Felipe-chr/RoboTZero/Docs/AuralFocus/auralfocus-intro.qmd

# First Technical Analysis and Architecture

This document presents the first technical analysis and proposed architecture for an artificial hearing system with capabilities that approach and in some aspects surpass human audition. The system employs six digital [MEMS](https://grokipedia.com/page/MEMS) microphones organized in two blocks of three elements each, enabling three-dimensional spatial localization of sound sources with extended dynamic range and advanced real-time digital signal processing capabilities.

The central objective is to create a device capable of identifying the origin of sound sources with angular resolution of three to five degrees, recording high-quality audio across the full audible spectrum, and detecting sporadic acoustic events such as explosions and aircraft with sub-20 millisecond latency. The architecture adopts an all-digital approach using I²S/PDM MEMS microphones, which significantly simplifies the analog design while maintaining professional-grade audio quality and reducing bill-of-materials cost to approximately sixty dollars.

## Fundamentals: Comparison Between Auditory Systems

To understand the project requirements and design decisions, we begin by analyzing the differences between human hearing, canine hearing, and the proposed system. This comparative analysis reveals both the biological limitations we seek to overcome and the engineering constraints that define practical boundaries.

### Human Auditory Characteristics

The human auditory system presents well-defined characteristics that have been extensively studied in psychoacoustic research. The audible frequency band extends from $20 \text{Hz}$ to approximately $20  \text{kHz}$ in young adults, though this upper limit degrades with age, typically reaching only $12$ to $15 \text{kHz}$ by age sixty. Maximum sensitivity occurs in the range between $2 \text{kHz}$ and  $4 \text{kHz}$, which corresponds to the fundamental frequencies and first formants of human speech, reflecting evolutionary optimization for verbal communication.

The dynamic range of human hearing, measured as the difference between the threshold of hearing and the threshold of pain, reaches approximately $120 \text{dB}$. This remarkable range allows us to perceive sounds from the faint rustle of leaves at $10 \text{dB}$ **S**ound **P**ressure Sound Pressure Levelevel, Sound Pressure Level to the roar of jet engines at $130 \text{dB}$ SPL. However, this sensitivity comes with vulnerability to acoustic trauma from prolonged exposure to high-intensity sounds above $85 \text{dB}$ **SPL**.

Human spatial localization capability depends fundamentally on two binaural mechanisms that exploit the separation between our ears. The first mechanism is Interaural Time Difference (ITD), which represents the difference in sound arrival time between the two ears. For a sound source positioned laterally, considering the typical interaural separation of approximately 17 centimeters in adult humans, we can calculate the maximum ITD:

$$
\text{ITD}_{\text{max}} = \frac{d}{v_{\text{sound}}} = \frac{0.17 \text{ m}}{343 \text{ m/s}} \approx 495 \text{ μs}
$$

This half-millisecond time difference is remarkably small, yet the human auditory system can detect differences as small as 10 microseconds, corresponding to angular discrimination of approximately one to two degrees in the frontal hemisphere. The sensitivity to **I**nteraural **T**ime **D**ifference, **ITD**, is greatest for frequencies below $1.5\text{kHz}$, where phase information remains unambiguous across the entire audible range.

The second mechanism is **I**nteraural **L**evel **D**ifference, **ILD**, which represents the difference in sound intensity between the ears due to the acoustic shadow cast by the head. This effect becomes significant when the wavelength of sound is smaller than or comparable to head dimensions. For a spherical head of approximately $18 \text{centimeters}$ diameter, this occurs at frequencies above approximately $2 \text{kHz}$:

$$f_{\text{ILD}} = \frac{v_{\text{sound}}}{\pi d_{\text{head}}} = \frac{343 \text{ m/s}}{\pi \times 0.18 \text{ m}} \approx 607 \text{ Hz}$$

Above this frequency, the head increasingly attenuates sound reaching the far ear, creating level differences that can exceed $20\text{dB}$ for pure lateral sources at high frequencies. The brain integrates both **ITD** and **ILD** cues to create a robust spatial representation, with **ITD** dominating at low frequencies and **ILD** at high frequencies.

Human angular resolution varies significantly with direction. In the frontal region, where both ears receive similar stimulation and head movements can disambiguate front-back confusions, we achieve resolution of approximately one degree. This exceptional acuity degrades to approximately $10$ to $15 \test{degrees}$ in lateral and posterior regions, where cone of confusion effects and reduced binaural information limit performance.

**[SVG DIAGRAM 1: Illustration of the human auditory system showing the 17cm interaural separation, with visualization of sound waves arriving from different angles and visual indication of ITD and ILD mechanisms]**

### Canine Auditory Characteristics

Canine hearing presents characteristics that make it superior to human hearing in specific aspects, reflecting evolutionary adaptations to different ecological niches. The frequency band extends from approximately 40 Hz to 60 kHz, with some breeds capable of detecting frequencies approaching 65 kHz. This extended high-frequency response enables dogs to perceive ultrasonic vocalizations from prey animals and potentially detect some electronic devices that emit ultrasonic noise.

Maximum sensitivity occurs between 8 kHz and 16 kHz, approximately one octave above peak human sensitivity. This shift reflects optimization for detecting higher-pitched sounds, including rodent vocalizations and rustling movements in vegetation. The dynamic range is similar to humans at approximately 100 dB, though dogs show greater sensitivity to faint sounds, with hearing thresholds 4 to 6 dB lower than human thresholds across most of the audible spectrum.

The separation between canine ears varies considerably with breed, typically ranging from 5 centimeters in small breeds to 10 centimeters in large breeds. Although smaller than human interaural separation, dogs compensate through independent pinnae mobility. Each external ear can rotate through approximately 180 degrees under precise muscular control, allowing dogs to actively scan the acoustic environment and effectively increase their spatial sampling aperture. This mobility provides dogs with dynamic beamforming capability that humans lack, partially offsetting the geometric disadvantage of smaller baseline.

Canine angular resolution in azimuth is estimated at approximately 5 degrees under optimal conditions, somewhat inferior to frontal human resolution but superior to human performance in lateral directions. The ability to rapidly orient pinnae toward sound sources provides dogs with faster spatial acquisition than humans, who must rely primarily on head movements for spatial disambiguation.

### Proposed System Specifications

The system we are designing seeks to combine the best characteristics of biological auditory systems while adding capabilities enabled by digital signal processing that have no biological analogue. The design philosophy emphasizes practical utility over theoretical perfection, focusing on capabilities that provide clear value for the intended applications of sound source localization, event detection, and high-quality audio recording.

The useful frequency band will extend from 20 Hz to 20 kHz, covering the complete audible range with flat response. While this lacks the ultrasonic extension of canine hearing, it provides complete coverage of acoustically relevant content for our target applications. The vast majority of informative content in explosions, aircraft noise, and speech occurs below 10 kHz, with harmonics extending to 20 kHz. Even for ultrasonic events such as bat echolocation or pneumatic leaks, the presence of harmonics within the audible band often provides sufficient detection capability.

The target dynamic range is 120 dB, matching human capability and allowing capture of sounds from very weak (20 dB SPL, equivalent to a quiet room) to extremely intense (140 dB SPL, near aircraft engines). The frequency response will be optimized to remain flat within ±2 dB from 100 Hz to 16 kHz, degrading gradually to ±3 dB at 20 kHz, providing faithful representation of sound sources without coloration.

The target angular resolution is 3 to 5 degrees in azimuth and 5 to 10 degrees in elevation. Although the system lacks physical mobility like canine pinnae, we compensate through digital beamforming, which allows electronically steering array sensitivity across the entire spatial hemisphere with millisecond update rates. This provides spatial tracking capability that exceeds biological systems for rapidly moving sources.

The system latency target is less than 20 milliseconds from acoustic event to digital output, enabling real-time monitoring and triggering applications. Processing will occur entirely on the embedded microcontroller, eliminating dependence on external computing resources and enabling standalone operation.

**[SVG DIAGRAM 2: Side-by-side comparison of the three auditory systems (human, canine, proposed) showing frequency bands on a logarithmic scale, with emphasis on regions of maximum sensitivity and dynamic range bars]**

## Microphone Array Geometry

The choice of microphone array geometry fundamentally determines the spatial localization capabilities and dictates many subsequent design decisions. The proposed configuration consists of two blocks of three microphones each, arranged vertically and separated horizontally, creating what we term a binaural array architecture.

### Topology and Dimensions

Each vertical block contains three microphones uniformly spaced by 15 millimeters center-to-center, resulting in a total aperture of 30 millimeters per block. The two blocks are separated horizontally by a distance of 100 millimeters, measured between the center microphones of each block. This creates a configuration that replicates the essential geometry of binaural hearing while adding a vertical dimension absent in simple two-microphone systems.

This geometry was selected through iterative analysis of several competing requirements. First, the vertical arrangement of microphones in each block enables beamforming in the elevation plane through delay-and-sum or more sophisticated adaptive techniques. Second, the horizontal separation between blocks provides sufficient baseline for exploiting both ITD and ILD cues to determine azimuth, similar to biological binaural hearing. Third, the compact overall dimensions (100 mm × 30 mm) permit mounting on a single printed circuit board without mechanical complexity.

The choice of 15 millimeter vertical spacing represents a compromise between spatial resolution and aliasing. Tighter spacing would reduce aliasing frequency but decrease angular resolution. Wider spacing would improve resolution but introduce ambiguities at lower frequencies. The selected spacing provides acceptable performance across the frequency range of interest.

The 100 millimeter horizontal separation was chosen to approximate the effective acoustic baseline of small animals while remaining compatible with standard PCB manufacturing. This separation provides ITD values up to approximately 290 microseconds for pure lateral sources, sufficient for unambiguous localization using correlation-based methods across the full audible band.

**[SVG DIAGRAM 3: Front and top view of the array showing the positions of the 6 microphones. Front view shows the two vertical blocks separated by 10cm. Top view shows the 10cm baseline. Include coordinate system with x, y, z axes clearly marked and microphone numbering]**

### Spacing Calculation and Spatial Aliasing

A critical concept in microphone array design is spatial aliasing, directly analogous to temporal aliasing in discrete-time signal processing. When the spacing between array elements exceeds half the wavelength of the incoming sound, ambiguities arise in determining the direction of arrival. Multiple spatial angles can produce identical phase relationships across the array, creating what are termed grating lobes in the array response pattern.

To avoid spatial aliasing, the spacing between adjacent elements must satisfy:

$$
d < \frac{\lambda_{\text{min}}}{2} = \frac{v_{\text{sound}}}{2 f_{\text{max}}}
$$

For our maximum frequency of interest of 20 kHz, this yields:

$$
\lambda_{\text{min}} = \frac{343 \text{ m/s}}{20000 \text{ Hz}} = 17.15 \text{ mm}
$$

Therefore, the maximum spacing to avoid aliasing is:

$$
d_{\text{max}} = \frac{17.15 \text{ mm}}{2} = 8.58 \text{ mm}
$$

Our chosen spacing of 15 millimeters exceeds this limit by a factor of 1.75, which means we will experience spatial aliasing above approximately:

$$
f_{\text{aliasing}} = \frac{v_{\text{sound}}}{2 \times d} = \frac{343 \text{ m/s}}{2 \times 0.015 \text{ m}} \approx 11.4 \text{ kHz}
$$

This represents a conscious design trade-off. Spatial aliasing above 11.4 kHz creates ambiguities in direction of arrival estimation, but several factors mitigate this limitation. First, most acoustic events of interest (speech, explosions, vehicle noise) contain their principal informative content below 10 kHz. Second, even when aliasing occurs, the energy detection and beamforming gain remain valid, only the precise angle-of-arrival becomes ambiguous. Third, the horizontal baseline of 100 millimeters provides an independent measurement at a different spatial frequency that helps resolve some ambiguities.

For applications requiring unambiguous localization across the full 20 kHz band, the vertical spacing would need to be reduced to approximately 8 millimeters. However, this would increase manufacturing difficulty and reduce the total vertical aperture, degrading elevation resolution. The chosen design prioritizes practical manufacturability and optimizes performance in the most critical frequency range.

### Local Beamforming Capabilities

Each vertical block of three microphones forms a uniform linear array (ULA) capable of performing beamforming in the elevation plane. For a ULA with $N$ elements spaced by distance $d$, the far-field array pattern when steering to angle $\theta_0$ from the array normal is given by:

$$
H(\theta, \omega) = \sum_{n=0}^{N-1} w_n e^{j \omega \tau_n}
$$

where $w_n$ are complex weights and $\tau_n = (n d \sin(\theta))/v_{\text{sound}}$ is the acoustic delay to element $n$. For a simple delay-and-sum beamformer with uniform weighting ($w_n = 1/N$), this simplifies to:

$$
H(\theta, \omega) = \frac{1}{N} \frac{\sin(N \omega d \sin(\theta) / (2 v_{\text{sound}}))}{\sin(\omega d \sin(\theta) / (2 v_{\text{sound}}))}
$$

The directivity pattern exhibits a main lobe centered at the steering angle $\theta_0$ and side lobes at angles where the path length differences equal integer multiples of the wavelength. The main lobe width at the -3 dB points is approximated by:

$$
\Delta\theta_{3\text{dB}} \approx \frac{0.886 \lambda}{(N-1)d}
$$

For our vertical array with $N=3$, $d=15$ millimeters, at a frequency of 1 kHz where $\lambda = 343$ millimeters:

$$
\Delta\theta_{3\text{dB}} \approx \frac{0.886 \times 343 \text{ mm}}{2 \times 15 \text{ mm}} \approx 10.1°
$$

This represents the angular resolution in elevation at 1 kHz. The beamwidth narrows at higher frequencies, reaching approximately 2.5 degrees at 4 kHz, our frequency of peak array gain. The directivity gain, which represents the improvement in signal-to-noise ratio achieved by coherent summation, is approximately:

$$
G_{\text{array}} = 10 \log_{10}(N) = 10 \log_{10}(3) \approx 4.8 \text{ dB}
$$

This 4.8 dB gain applies when the desired signal arrives from the steering direction and noise is spatially uncorrelated. In practice, gains of 3 to 4 dB are typical accounting for microphone mismatch and finite coherence of the desired signal.

**[SVG DIAGRAM 4: Polar pattern of vertical beamforming showing the main lobe and side lobes at three frequencies: 500 Hz (wide beam), 2 kHz (medium), and 8 kHz (narrow). Include angular scale in degrees and magnitude scale in dB]**

### Binaural Analysis for Azimuth Determination

The 100 millimeter horizontal separation between left and right blocks enables binaural analysis for azimuth determination. For a sound source at azimuth angle $\phi$ measured from the frontal direction, the maximum interaural time difference for pure lateral incidence ($\phi = 90°$) is:

$$
\text{ITD}_{\text{max}} = \frac{d_{\text{separation}}}{v_{\text{sound}}} = \frac{0.10 \text{ m}}{343 \text{ m/s}} \approx 291 \text{ μs}
$$

For arbitrary azimuth angles, the ITD can be approximated under far-field conditions by:

$$
\text{ITD}(\phi) = \frac{d_{\text{separation}}}{v_{\text{sound}}} \sin(\phi)
$$

This relationship is valid when the source distance greatly exceeds the array dimensions, allowing treatment of the wavefront as planar. For sources within approximately two meters, near-field corrections become necessary to account for wavefront curvature.

The angular resolution achievable through ITD analysis depends on the minimum detectable time difference, which is limited by sampling rate, signal-to-noise ratio, and correlation processing gain. With a sampling rate of 48 kHz providing temporal resolution of approximately 21 microseconds, and assuming signal-to-noise ratio of 20 dB enabling detection of time delays to approximately 10 microseconds through correlation processing, the theoretical angular resolution is:

$$
\Delta\phi_{\text{min}} = \arcsin\left(\frac{v_{\text{sound}} \times \Delta t_{\text{min}}}{d_{\text{separation}}}\right) = \arcsin\left(\frac{343 \text{ m/s} \times 10 \times 10^{-6} \text{ s}}{0.10 \text{ m}}\right) \approx 2.0°
$$

This calculation indicates that our geometry is capable of achieving the target angular resolution of 3 to 5 degrees with margin. In practice, reverberation, competing sources, and finite signal bandwidth will degrade performance from this theoretical limit, but the fundamental geometry provides adequate capability.

The interaural level difference also contributes to azimuth determination, particularly at high frequencies where the wavelength becomes comparable to the array dimensions. For our 100 millimeter separation, ILD becomes significant above approximately:

$$
f_{\text{ILD}} = \frac{v_{\text{sound}}}{\pi d_{\text{separation}}} = \frac{343 \text{ m/s}}{\pi \times 0.10 \text{ m}} \approx 1.1 \text{ kHz}
$$

Above this frequency, each vertical block begins to shadow the other for lateral sources, creating level differences that complement ITD cues. The magnitude of ILD increases with frequency and angle, potentially reaching 10 to 15 dB for high-frequency pure lateral sources.

**[SVG DIAGRAM 5: Top view showing plane waves arriving at different azimuth angles (0°, 30°, 60°, 90°) with visualization of path length differences between left and right blocks. Include time delay annotations and graphical wavefront representations]**
