Felipe-chr/RoboTZero/Docs/AuralFocus/images/STMPowerDistShcdV1.webp

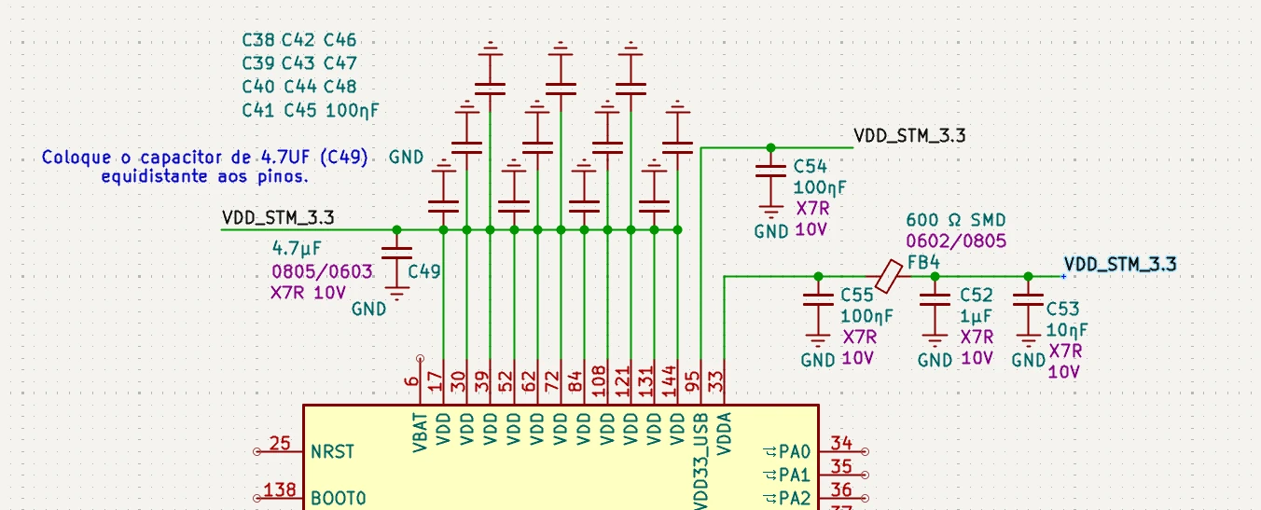
Docs/AuralFocus/images/STMPowerDistShcdV1.webp
