Felipe-chr/RoboTZero/AuralFocus/hardware/aurial1/aurialPiHat/aurialPiHat.kicad_sch

## KiCad design AuralFocus/hardware/aurial1/aurialPiHat/aurialPiHat.kicad_sch (2026-01-05)

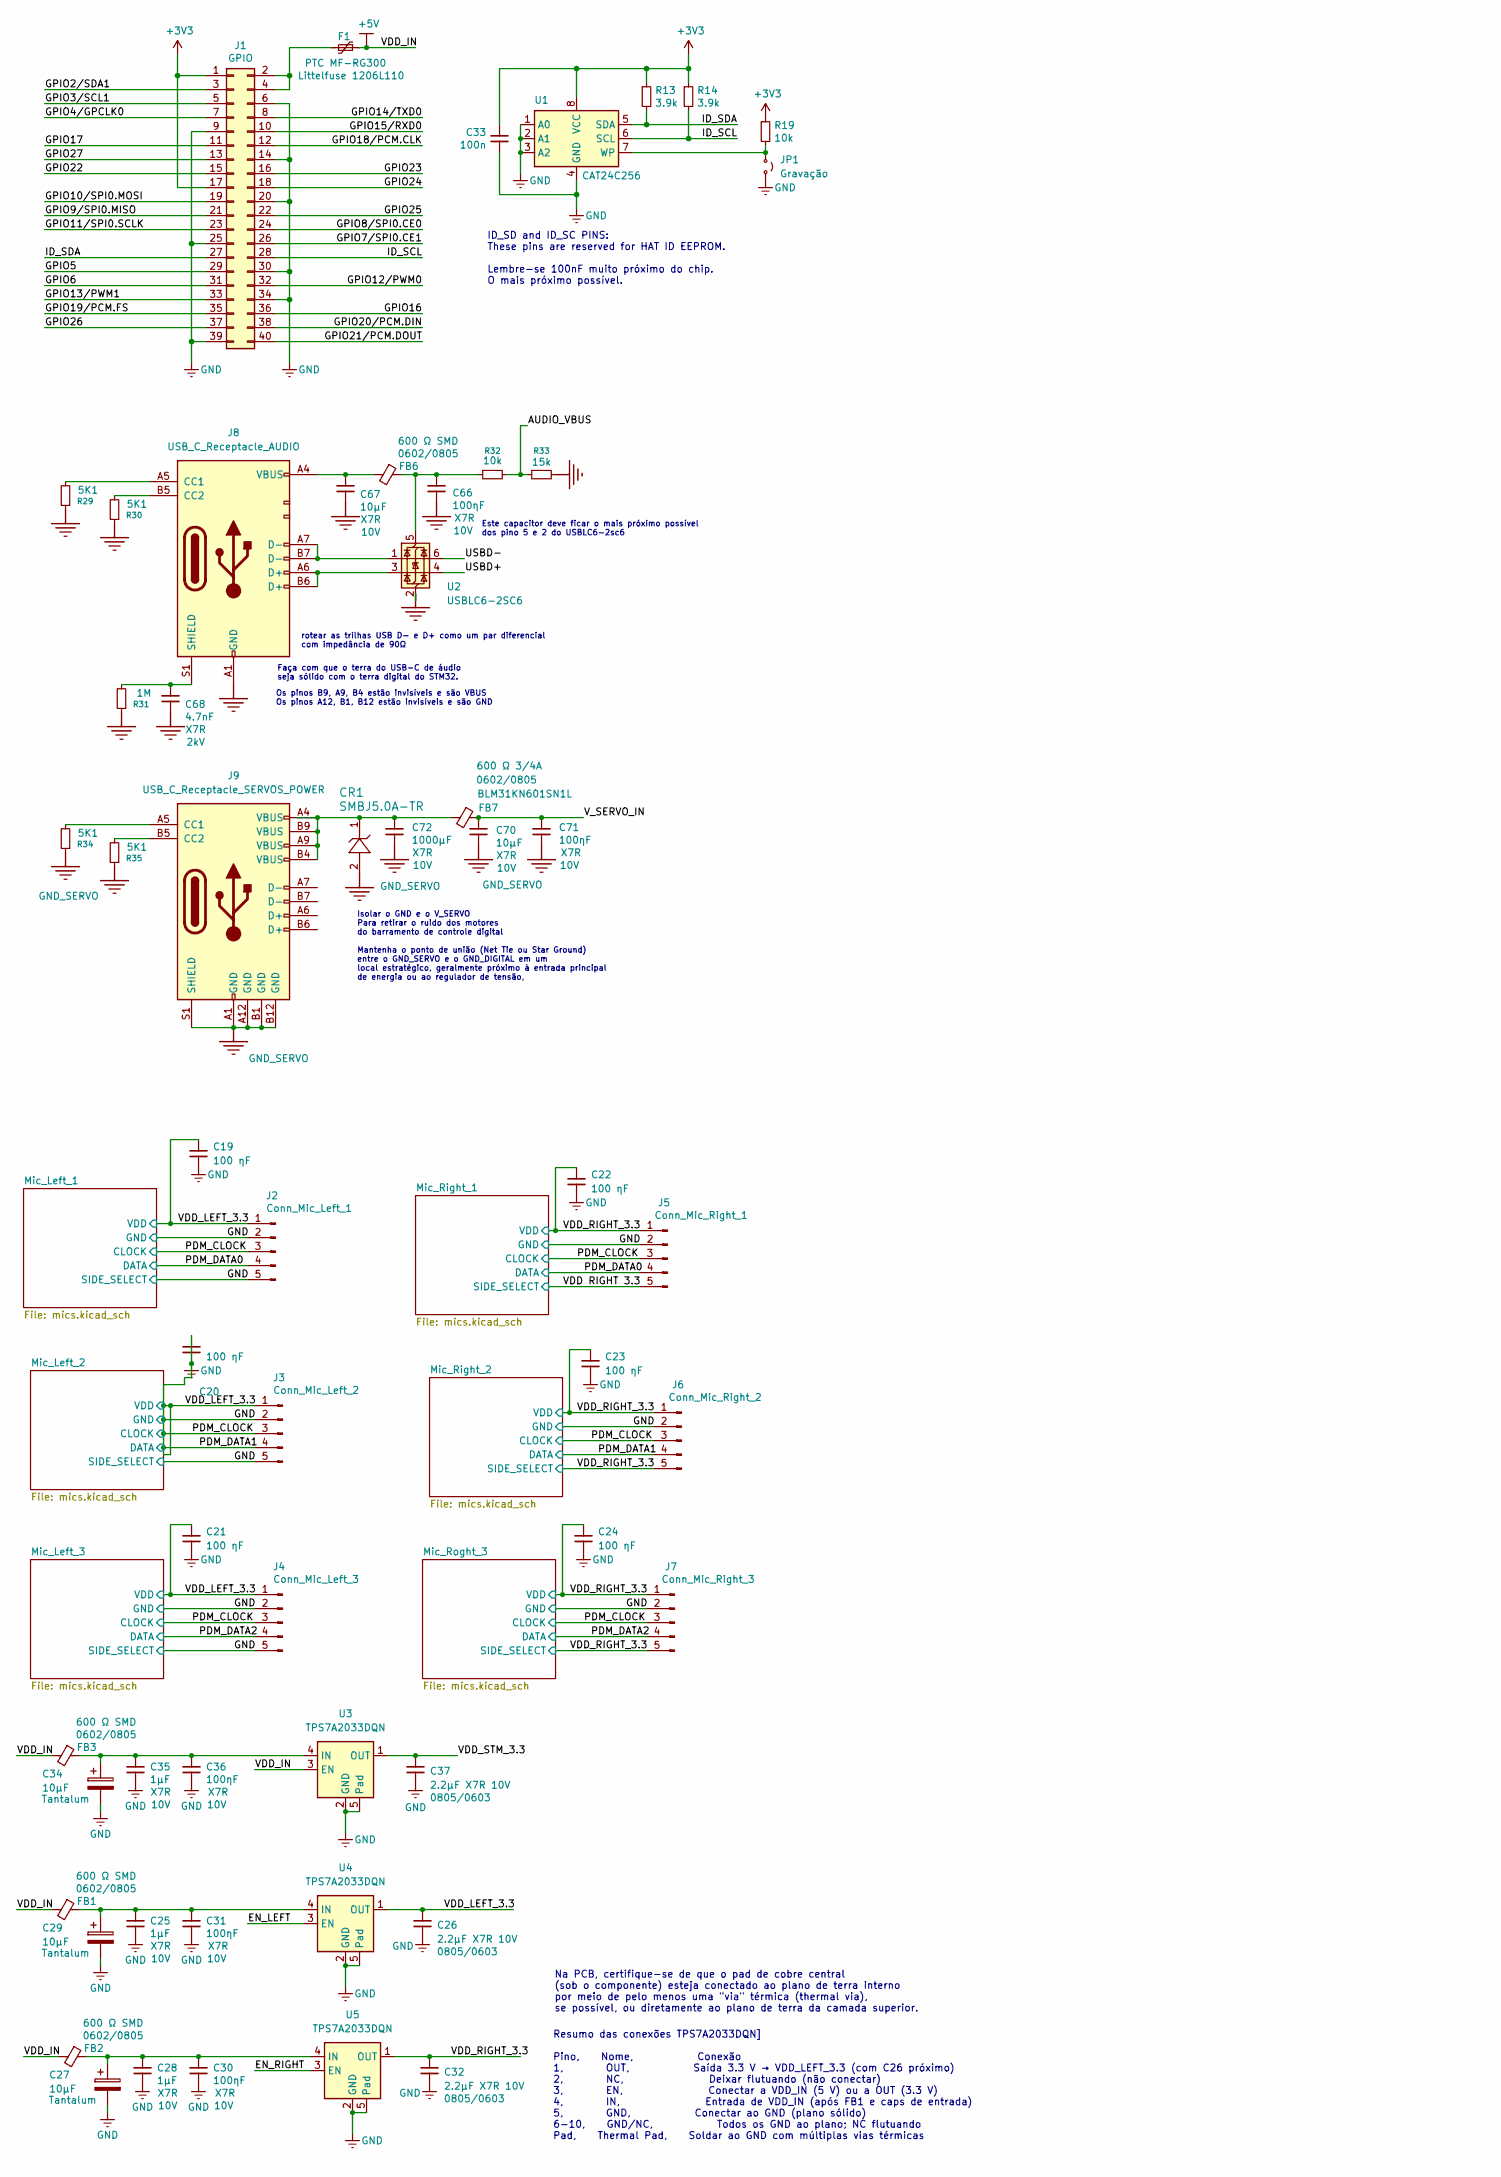
[picture p5: schematic aurialPiHat.kicad_sch, part in row 1, column 1]

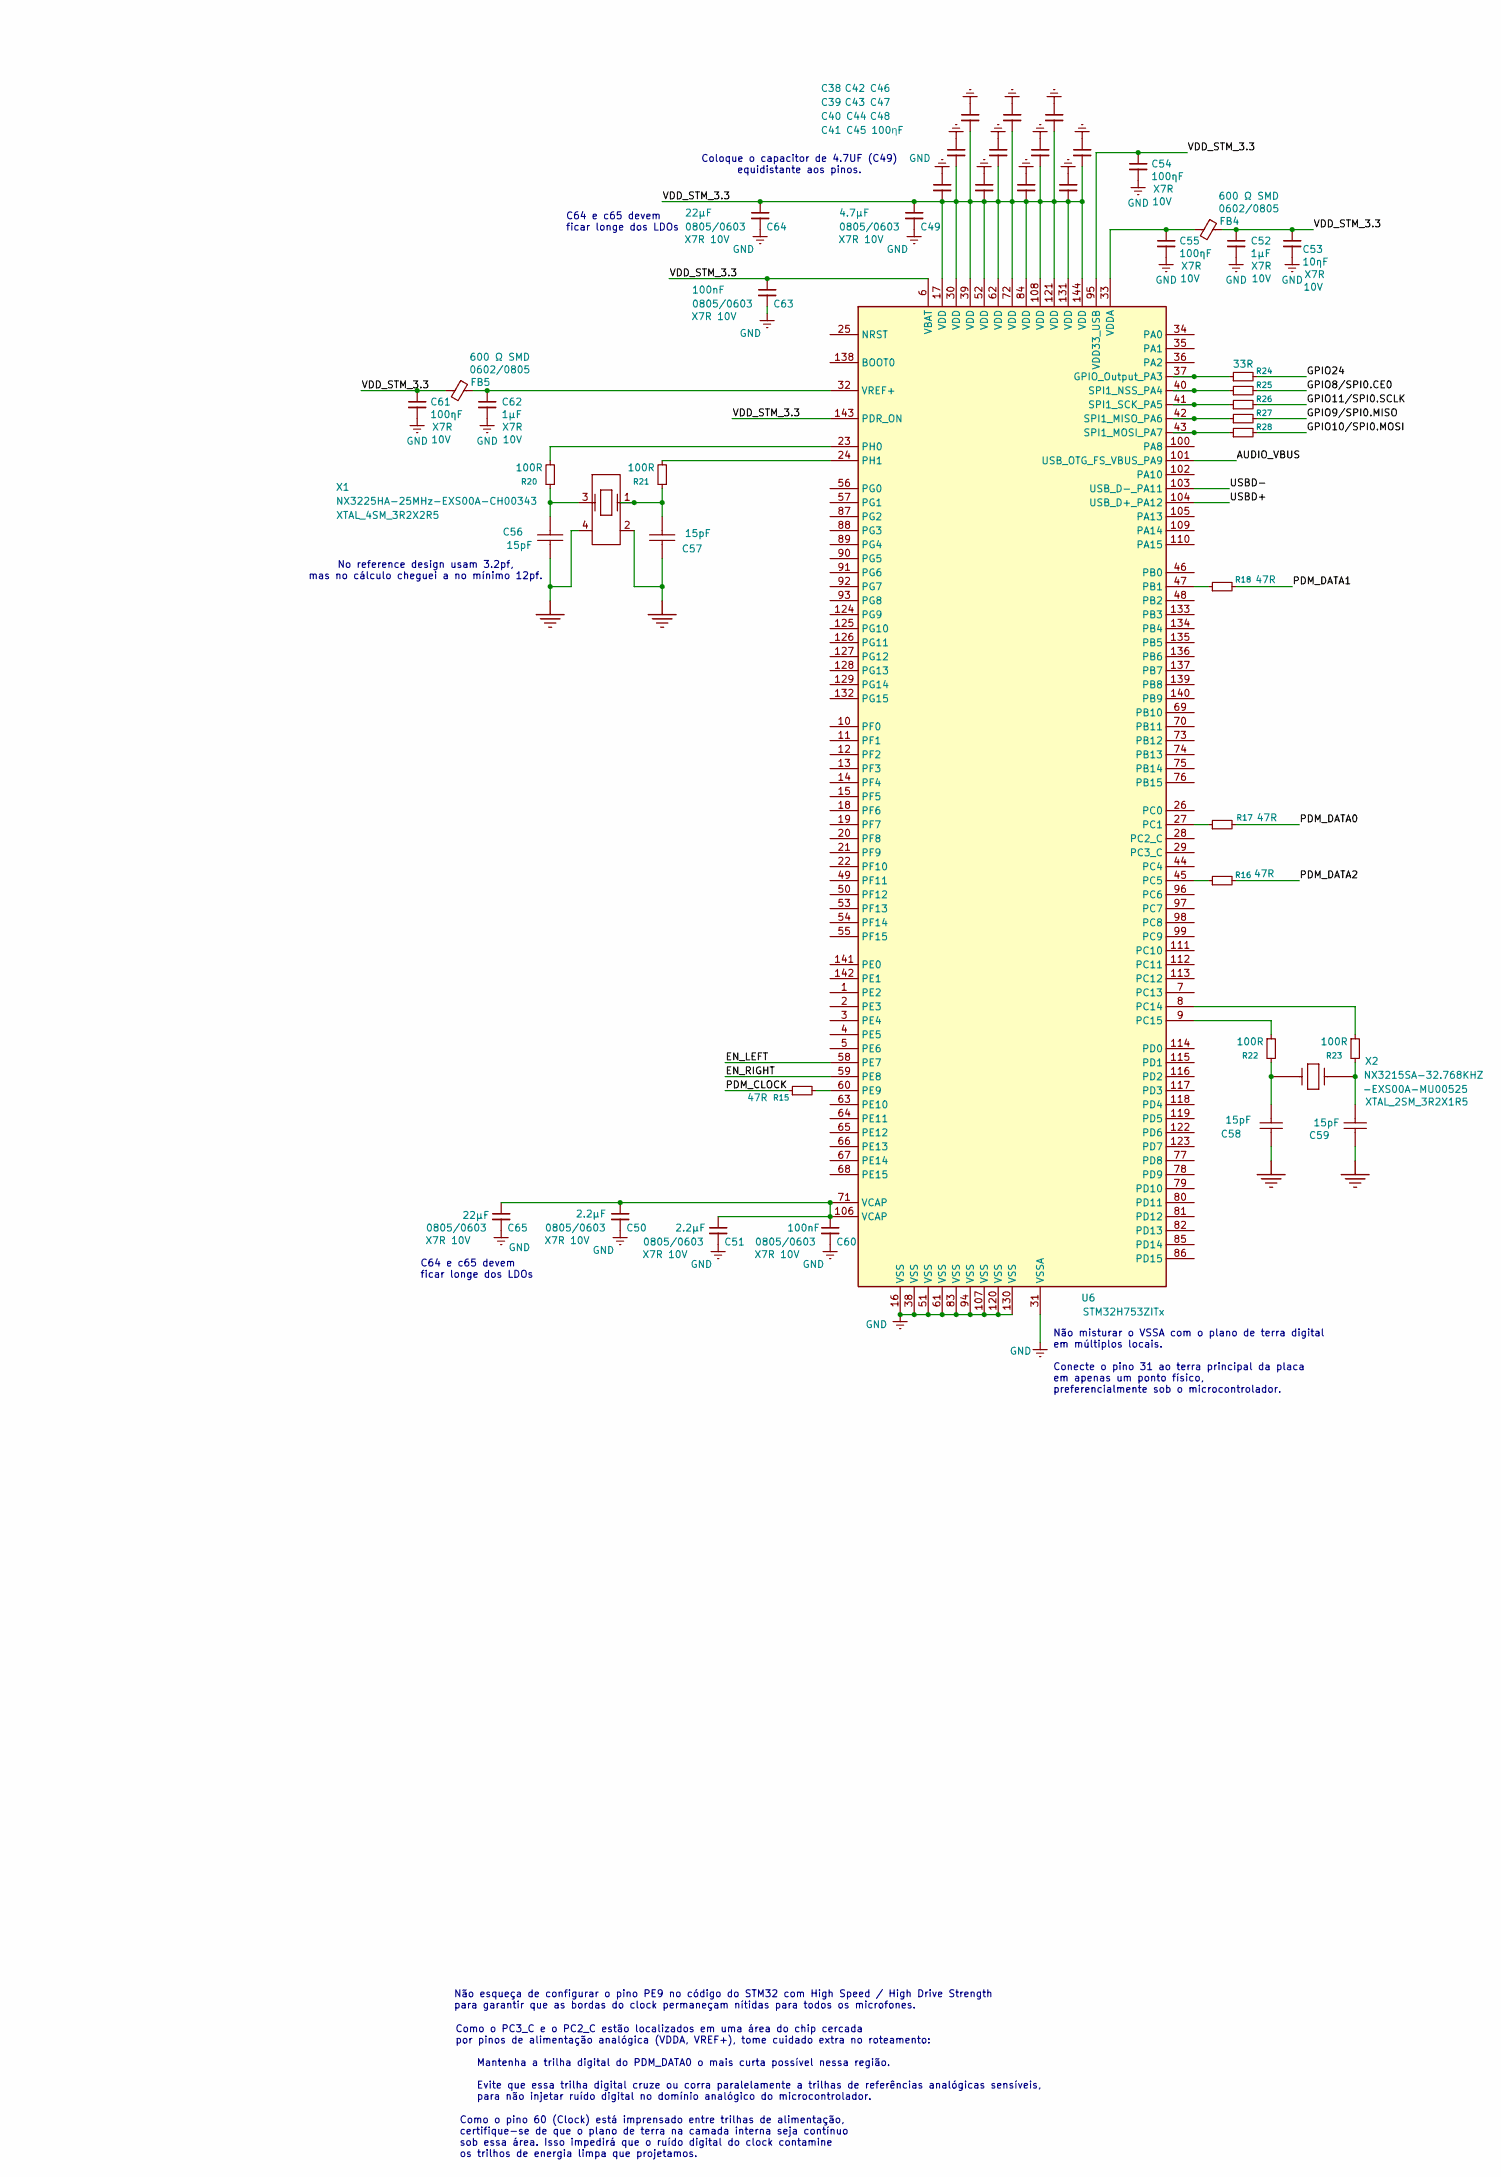
[picture p6: schematic aurialPiHat.kicad_sch, part in row 1, column 2]

Parts:
C19, C20, C21, C22, C23, C24: 100 ηF
C25, C28, C35, C52, C62: 1μF
C26, C32, C37: 2.2μF X7R 10V
C27, C29, C34, C67, C70: 10μF
C30, C31, C36, C54, C55, C61, C66, C71: 100ηF
C33: 100n
C38, C39, C40, C41, C42, C43, C44, C45, C46, C47, C48: 100ƞF
C49: 4.7μF
C50, C51: 2.2μF
C53: 10ηF
C56, C57, C58, C59: 15pF; 0603C
C60, C63: 100nF
C64, C65: 22μF
C68: 4.7nF
C72: 1000μF
CR1: SMBJ5.0A-TR; SMB_STM
F1: PTC MF-RG300
FB1, FB2, FB3, FB4, FB5, FB6: 600 Ω SMD
FB7: 600 Ω 3/4A; Part BLM31KN601SN1L
J1: GPIO; PinSocket_2x20_P2.54mm_Vertical
J2: Conn_Mic_Left_1
J3: Conn_Mic_Left_2
J4: Conn_Mic_Left_3
J5: Conn_Mic_Right_1
J6: Conn_Mic_Right_2
J7: Conn_Mic_Right_3
J8: USB_C_Receptacle_AUDIO
J9: USB_C_Receptacle_SERVOS_POWER
JP1: Gravação
R13, R14: 3.9k
R15, R16, R17, R18: 47R
R19, R32: 10k
R20, R21, R22, R23: 100R
R24, R25, R26, R27, R28: 33R
R29, R30, R34, R35: 5K1
R31: 1M
R33: 15k
U1: CAT24C256
U2: USBLC6-2SC6; SOT-23-6
U3, U4, U5: TPS7A2033DQN; Texas_X2SON-4_1x1mm_P0.65mm
U6: STM32H753ZITx; LQFP-144_20x20mm_P0.5mm
X1: NX3225HA-25MHz-EXS00A-CH00343; XTAL_4SM_3R2X2R5
X2: NX3215SA-32.768KHZ; XTAL_2SM_3R2X1R5

Connections:
+3V3: C33.1, J1.1, J1.17, R13.1, R14.1, R19.1, U1.8 (VCC)
+5V: F1.1, FB1.2, FB2.2, FB3.2, U3.3 (EN)
AUDIO_VBUS: R32.2, R33.1, U6.101 (USB_OTG_FS_VBUS_PA9)
EN_LEFT: U4.3 (EN), U6.58 (PE7)
EN_RIGHT: U5.3 (EN), U6.59 (PE8)
GND: C19.1, C19.2, C20.1, C20.2, C21.1, C21.2, C22.2, C23.2, C24.2, C25.2, C26.1, C26.2, C27.2, C28.2, C29.2, C30.2, C31.2, C32.2, C33.2, C34.2, C35.2, C36.2, C37.2, C38.1, C39.1, C40.1, C41.1, C42.1, C43.1, C44.1, C45.1, C46.1, C47.1, C48.1, C49.2, C50.2, C51.2, C52.2, C53.2, C54.2, C55.2, C58.2, C59.2, C60.2, C61.2, C62.2, C63.2, C64.2, C65.2, C66.2, C67.2, C68.2, C70.2, C72.2, J1.6, J1.9, J1.14, J1.20, J1.25, J1.30, J1.34, J1.39, J2.1, J2.2, J2.3, J2.5, J3.1, J3.2, J3.3, J3.4, J3.5, J4.1, J4.2, J4.3, J4.5, J5.2, J5.3, J6.2, J6.3, J6.4, J7.2, J7.3, J8.A1 (GND), J8.A12 (GND), J8.B1 (GND), J8.B12 (GND), JP1.2 (B), R15.1, R18.2, R29.1, R30.1, R31.1, R33.2, U1.1 (A0), U1.2 (A1), U1.3 (A2), U1.4 (GND), U2.2 (GND), U3.2 (GND), U3.5 (Pad), U4.1 (OUT), U4.2 (GND), U4.5 (Pad), U5.2 (GND), U5.5 (Pad), U6.16 (VSS), U6.31 (VSSA), U6.38 (VSS), U6.51 (VSS), U6.61 (VSS), U6.83 (VSS), U6.94 (VSS), U6.107 (VSS), U6.120 (VSS), U6.130 (VSS)
GND_SERVO: C71.2, CR1.2, J9.A1 (GND), J9.A12 (GND), J9.B1 (GND), J9.B12 (GND), J9.S1 (SHIELD), R34.1, R35.1
GPIO2/SDA1: J1.3
GPIO3/SCL1: J1.5
GPIO4/GPCLK0: J1.7
GPIO5: J1.29
GPIO6: J1.31
GPIO7/SPI0.CE1: J1.26
GPIO8/SPI0.CE0: J1.24, R25.2
GPIO9/SPI0.MISO: J1.21, R27.2
GPIO10/SPI0.MOSI: J1.19, R28.2
GPIO11/SPI0.SCLK: J1.23, R26.2
GPIO12/PWM0: J1.32
GPIO13/PWM1: J1.33
GPIO14/TXD0: J1.8
GPIO15/RXD0: J1.10
GPIO16: J1.36
GPIO17: J1.11
GPIO18/PCM.CLK: J1.12
GPIO19/PCM.FS: J1.35
GPIO20/PCM.DIN: J1.38
GPIO21/PCM.DOUT: J1.40
GPIO22: J1.15
GPIO23: J1.16
GPIO24: J1.18, R24.2
GPIO25: J1.22
GPIO26: J1.37
GPIO27: J1.13
ID_SCL: J1.28, R14.2, U1.6 (SCL)
ID_SDA: J1.27, R13.2, U1.5 (SDA)
unnamed: C25.1, C29.1, C31.1, FB1.1, U4.4 (IN)
unnamed: C27.1, C28.1, C30.1, FB2.1, U5.4 (IN)
unnamed: C34.1, C35.1, C36.1, FB3.1, U3.4 (IN)
unnamed: C50.1, C51.1, C60.1, C65.1, U6.71 (VCAP), U6.106 (VCAP)
unnamed: C55.1, FB4.2, U6.33 (VDDA)
unnamed: C56.1, R20.1, X1.3
unnamed: C56.2, X1.4
unnamed: C57.1, R21.1, X1.1
unnamed: C57.2, X1.2
unnamed: C58.1, R22.2, X2.2
unnamed: C59.1, R23.2, X2.1
unnamed: C62.1, FB5.1, U6.32 (VREF+)
unnamed: C66.1, FB6.1, R32.1, U2.5 (VBUS)
unnamed: C67.1, FB6.2, J8.A4 (VBUS), J8.A9 (VBUS), J8.B4 (VBUS), J8.B9 (VBUS)
unnamed: C68.1, J8.S1 (SHIELD), R31.2
unnamed: C72.1, CR1.1, FB7.2, J9.A4 (VBUS), J9.A9 (VBUS), J9.B4 (VBUS), J9.B9 (VBUS)
unnamed: F1.2, J1.2, J1.4
unnamed: J8.A5 (CC1), R29.2
unnamed: J8.A6 (D+), J8.B6 (D+), U2.3 (I/O2)
unnamed: J8.A7 (D-), J8.B7 (D-), U2.1 (I/O1)
unnamed: J8.B5 (CC2), R30.2
unnamed: J9.A5 (CC1), R34.2
unnamed: J9.B5 (CC2), R35.2
unnamed: JP1.1 (A), R19.2, U1.7 (WP)
unnamed: R15.2, U6.60 (PE9)
unnamed: R16.1, U6.45 (PC5)
unnamed: R17.1, U6.27 (PC1)
unnamed: R18.1, U6.47 (PB1)
unnamed: R20.2, U6.23 (PH0)
unnamed: R21.2, U6.24 (PH1)
unnamed: R22.1, U6.9 (PC15)
unnamed: R23.1, U6.8 (PC14)
unnamed: R24.1, U6.37 (GPIO_Output_PA3)
unnamed: R25.1, U6.40 (SPI1_NSS_PA4)
unnamed: R26.1, U6.41 (SPI1_SCK_PA5)
unnamed: R27.1, U6.42 (SPI1_MISO_PA6)
unnamed: R28.1, U6.43 (SPI1_MOSI_PA7)
PDM_DATA0: J2.4, J5.4, R17.2
PDM_DATA2: J4.4, J7.4, R16.2
USBD+: U2.4 (I/O2), U6.104 (USB_D+_PA12)
USBD-: U2.6 (I/O1), U6.103 (USB_D-_PA11)
VDD RIGHT 3.3: J5.5
VDD_RIGHT_3.3: C22.1, C23.1, C24.1, C32.1, J5.1, J6.1, J6.5, J7.1, J7.5, U5.1 (OUT)
VDD_STM_3.3: C37.1, C38.2, C39.2, C40.2, C41.2, C42.2, C43.2, C44.2, C45.2, C46.2, C47.2, C48.2, C49.1, C52.1, C53.1, C54.1, C61.1, C63.1, C64.1, FB4.1, FB5.2, U3.1 (OUT), U6.6 (VBAT), U6.17 (VDD), U6.30 (VDD), U6.39 (VDD), U6.52 (VDD), U6.62 (VDD), U6.72 (VDD), U6.84 (VDD), U6.95 (VDD33_USB), U6.108 (VDD), U6.121 (VDD), U6.131 (VDD), U6.143 (PDR_ON), U6.144 (VDD)
V_SERVO_IN: C70.1, C71.1, FB7.1

Notes on the sheet:
Não esqueça de configurar o pino PE9 no código do STM32 com High Speed / High Drive Strength para garantir que as bordas do clock permaneçam nítidas para todos os microfones.
ID_SD and ID_SC PINS: These pins are reserved for HAT ID EEPROM. Lembre-se 100nF muito próximo do chip. O mais próximo possível.
Como o PC3_C e o PC2_C estão localizados em uma área do chip cercada por pinos de alimentação analógica (VDDA, VREF+), tome cuidado extra no roteamento: Mantenha a trilha digital do PDM_DATA0 o mais curta possível nessa região. Evite que essa trilha digital cruze ou corra paralelamente a trilhas de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
Isolar o GND e o V_SERVO Para retirar o ruido dos motores do barramento de controle digital
Os pinos B9, A9, B4 estão invisíveis e são VBUS Os pinos A12, B1, B12 estão invisíveis e são GND
Coloque o capacitor de 4.7UF (C49) equidistante aos pinos.
C64 e c65 devem ficar longe dos LDOs
Na PCB, certifique-se de que o pad de cobre central (sob o componente) esteja conectado ao plano de terra interno por meio de pelo menos uma "via" térmica (thermal via), se possível, ou diretamente ao plano de terra da camada superior.
Este capacitor deve ficar o mais próximo possível dos pino 5 e 2 do USBLC6-2sc6
Resumo das conexões TPS7A2033DQN] Pino, Nome, Conexão 1, OUT, Saída 3.3 V → VDD_LEFT_3.3 (com C26 próximo) 2, NC, Deixar flutuando (não conectar) 3, EN, Conectar a VDD_IN (5 V) ou a OUT (3.3 V) 4, IN, Entrada de VDD_IN (após FB1 e caps de entrada) 5, GND, Conectar ao GND (plano sólido) 6-10, GND/NC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
Mantenha o ponto de união (Net Tie ou Star Ground) entre o GND_SERVO e o GND_DIGITAL em um local estratégico, geralmente próximo à entrada principal de energia ou ao regulador de tensão,
Como o pino 60 (Clock) está imprensado entre trilhas de alimentação, certifique-se de que o plano de terra na camada interna seja contínuo sob essa área. Isso impedirá que o ruído digital do clock contamine os trilhos de energia limpa que projetamos.
rotear as trilhas USB D- e D+ como um par diferencial com impedância de 90Ω
Faça com que o terra do USB-C de áudio seja sólido com o terra digital do STM32.
Não misturar o VSSA com o plano de terra digital em múltiplos locais. Conecte o pino 31 ao terra principal da placa em apenas um ponto físico, preferencialmente sob o microcontrolador.
No reference design usam 3.2pf, mas no cálculo cheguei a no mínimo 12pf.
