Felipe-chr/RoboTZero/AuralFocus/hardware/aurial1/aurialPiHat/mics.kicad_sch

## KiCad design AuralFocus/hardware/aurial1/aurialPiHat/mics.kicad_sch (2025-12-30)

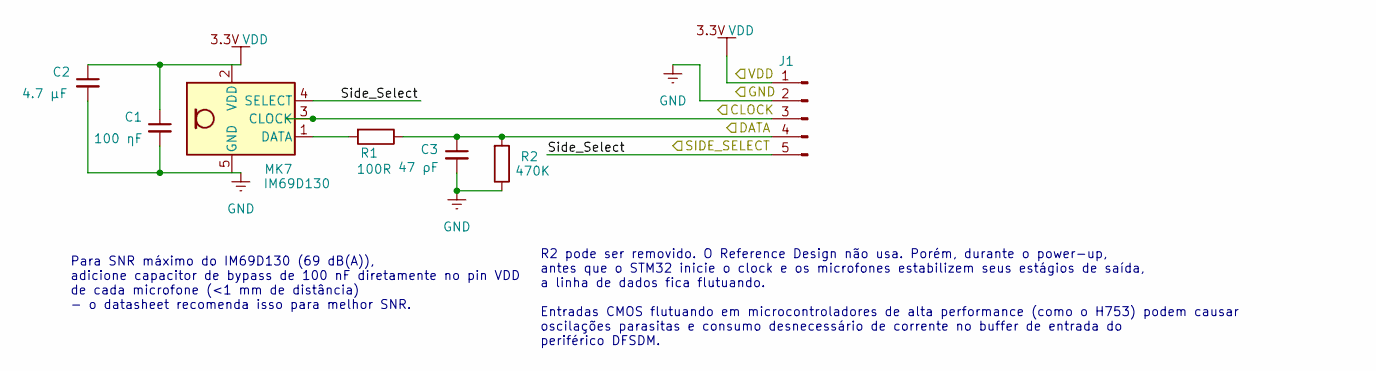
[picture p7: schematic mics.kicad_sch]

Parts:
C1: 100 ηF
C2: 4.7 μF
C3: 47 ρF
J1: Conn_01x05_Pin
MK7: IM69D130; Infineon_PG-LLGA-5-1
R1: 100R
R2: 470K

Connections:
GND: C1.2, C2.2, C3.2, J1.2, R2.1
unnamed: C3.1, J1.4, R1.1, R2.2
unnamed: J1.3, MK7.3 (CLOCK)
unnamed: MK7.1 (DATA), R1.2
SIDE_SELECT: J1.5, MK7.4 (SELECT)
VDD: C1.1, C2.1, J1.1

Notes on the sheet:
R2 pode ser removido. O Reference Design não usa. Porém, durante o power-up, antes que o STM32 inicie o clock e os microfones estabilizem seus estágios de saída, a linha de dados fica flutuando. Entradas CMOS flutuando em microcontroladores de alta performance (como o H753) podem causar oscilações 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
Para SNR máximo do IM69D130 (69 dB(A)), adicione capacitor de bypass de 100 nF diretamente no pin VDD de cada microfone (<1 mm de distância) - o datasheet recomenda isso para melhor SNR.
