Felipe-chr/RoboTZero/(commit log)

2024-11-19 teste de commit
2024-11-22 Corrections in motor test code
2025-11-05 Initialize line follower simulator project structure
    Create complete project structure for web-based line follower simulator
    with physics simulation, optimization, and 3D visualization.
    Frontend (Svelte + Three.js):
    - Svelte components for track editor, robot config, simulation view, and 3D viewer
    - State management with Svelte stores (project, simulation, UI)
    - Storage layer with IndexedDB, serialization, and URL encoding
    - Three.js modules for 3D scene, robot model, and track visualization
    - Web Worker for background optimization tasks
    Backend (C++ + WebAssembly):
    - Simulator class with Box2D integration (placeholder for Phase 1)
    - Optimizer with artifact-based hierarchical decomposition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
2025-11-05 Add comprehensive installation guide documentation
    Create Quarto-based documentation system in Docs/ directory:
    Installation Guide (installation-guide.qmd):
    - Complete setup guide for Ubuntu 24.04 on WSL2/Windows 11
    - WSL2 configuration and optimization
    - Git and GitHub setup with SSH keys
    - Visual Studio Code installation and essential extensions
    - C++ development environment (GCC 13.x, Clang 18.x, CMake)
    - Node.js 20.x LTS installation via nvm
    - Svelte development setup and testing
    - Emscripten SDK for WebAssembly compilation
    - PlatformIO installation and USB device access in WSL2
    - Box2D physics engine installation
    - Quarto documentation system setup
    - RoboTZero project cloning and build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
2025-11-12 primeira lista de material, alguns dos datasheets
2025-12-24 Microfones e reguladores para os microfones
2025-12-25 Correções no filtro do regulador de 3.3V
2025-12-29 Muitas mudanças no circuito, clocks no stm32h7 e mais,
2025-12-30 correções, VDD, VSS e outros pinos relevantes para contexto.
    ### Decoupling Strategy for STM32H753 Power Pins
    The STM32H753 microcontroller is a high-performance Cortex-M7 device operating at up to 480 MHz, with integrated USB High-Speed functionality. Such high-speed operation demands a robust power supply decoupling strategy to ensure signal integrity and minimize electromagnetic interference (EMI). Below is the detailed decoupling approach implemented in the AuralFocus HAT design:
    **1. Global Power Filtering**
    - **Ferrite Bead (FB3 - 600 Ω @ 100 MHz)**: placed on the main 3.3 V supply line feeding the STM32H753. This ferrite bead attenuates high-frequency noise originating from u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
2026-01-05 inclusão dos datasheets e dos circuitos de usb, para alimentação dos servos e para o audio
2026-01-05 Add MIT License to the project
    Adicionando uma licença para este repositório.
2026-01-05 pequenas correções, mais organização que qualquer outra coisa
